tony-mikhailov/w27cxxx/docs/scheme rev.2.9.jpg

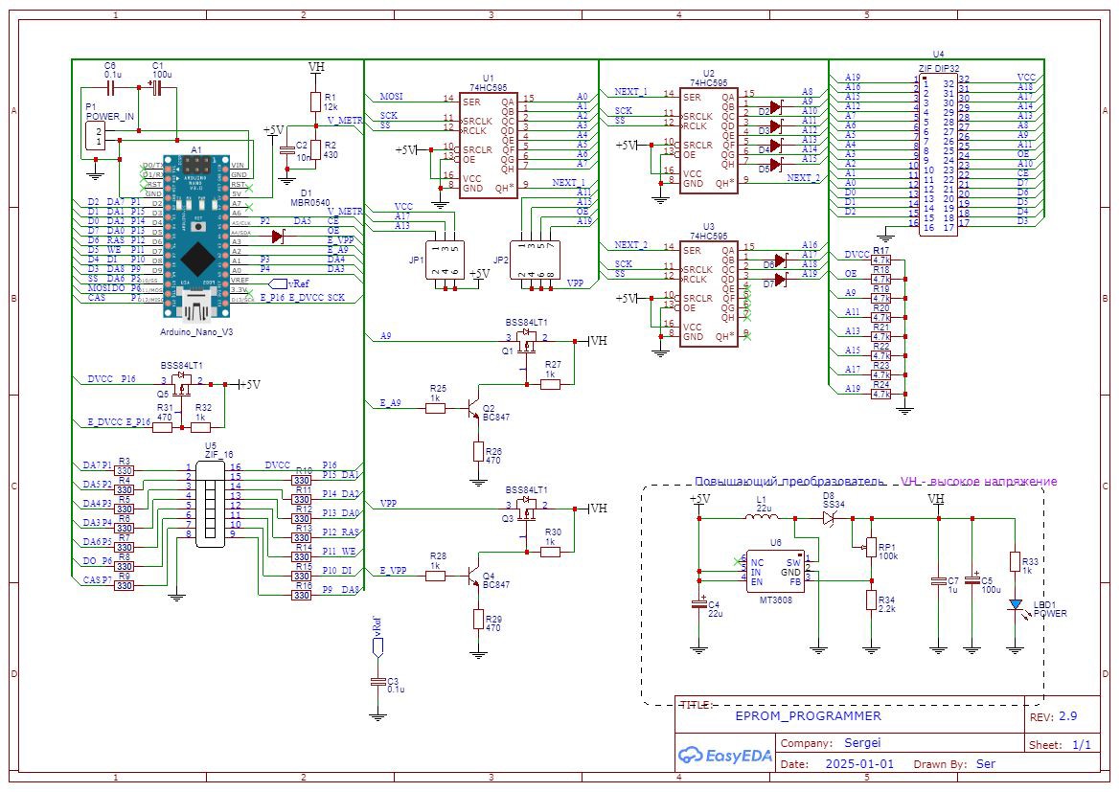
docs/scheme rev.2.9.jpg
