tony-mikhailov/w27cxxx/ListLogic.txt

Список микросхем логики

4000
4001
4002
4009
4010
40106
4011
4012
4013
4015
4016
40161
40162
4017
40174
40175
4018
4019
40192
40193
4020
4022
4023
4024
4025
4027
4028
4029
4030
4031
4040
4041
4042
4043
4044
4048
4049
4050
4051
4053
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
