tony-mikhailov/w27cxxx/docs/Screenshot from 2025-07-10 21-50-37.png

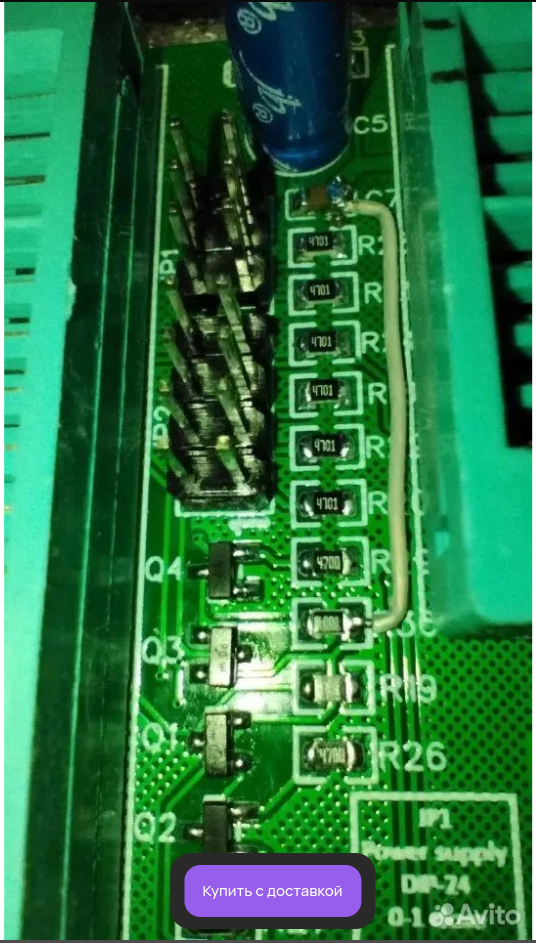
docs/Screenshot from 2025-07-10 21-50-37.png
