tony-mikhailov/w27cxxx/image.jpeg

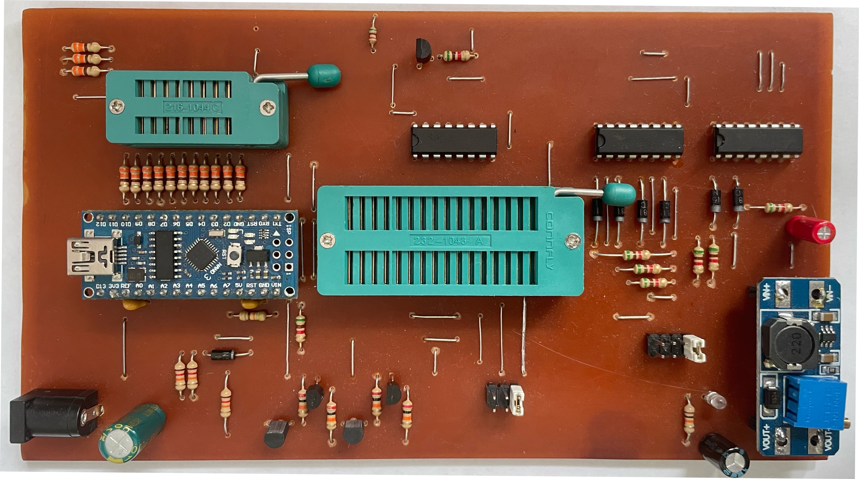
image.jpeg
