tony-mikhailov/w27cxxx/image/27c010.png

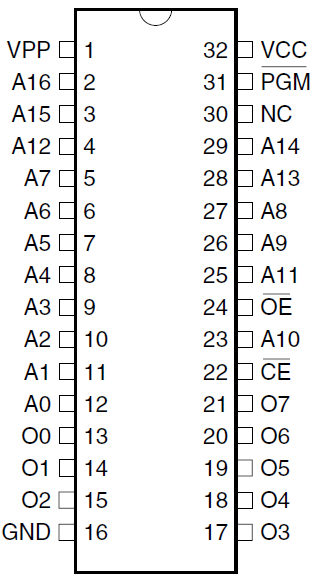
image/27c010.png
