tony-mikhailov/w27cxxx/image/27c16.png

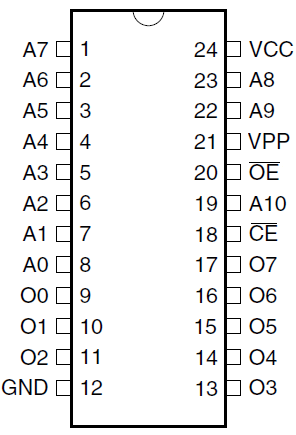
image/27c16.png
