tony-mikhailov/w27cxxx/image/27c32.png

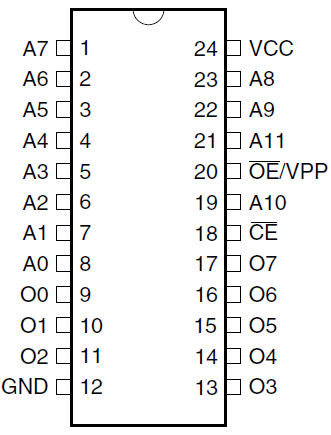
image/27c32.png
