tony-mikhailov/w27cxxx/image/28c010.png

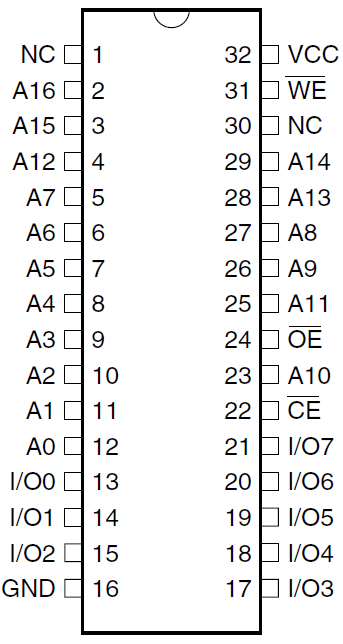
image/28c010.png
