tony-mikhailov/w27cxxx/image/28c17.png

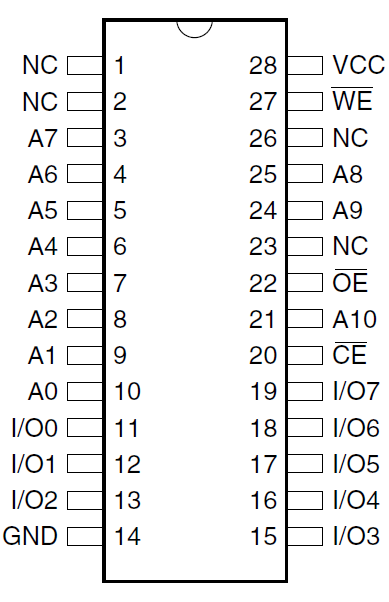
image/28c17.png
