tony-mikhailov/w27cxxx/image/dram64.png

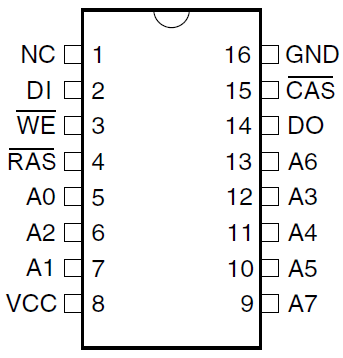
image/dram64.png
