tony-mikhailov/w27cxxx/Schematic rev1.0.png

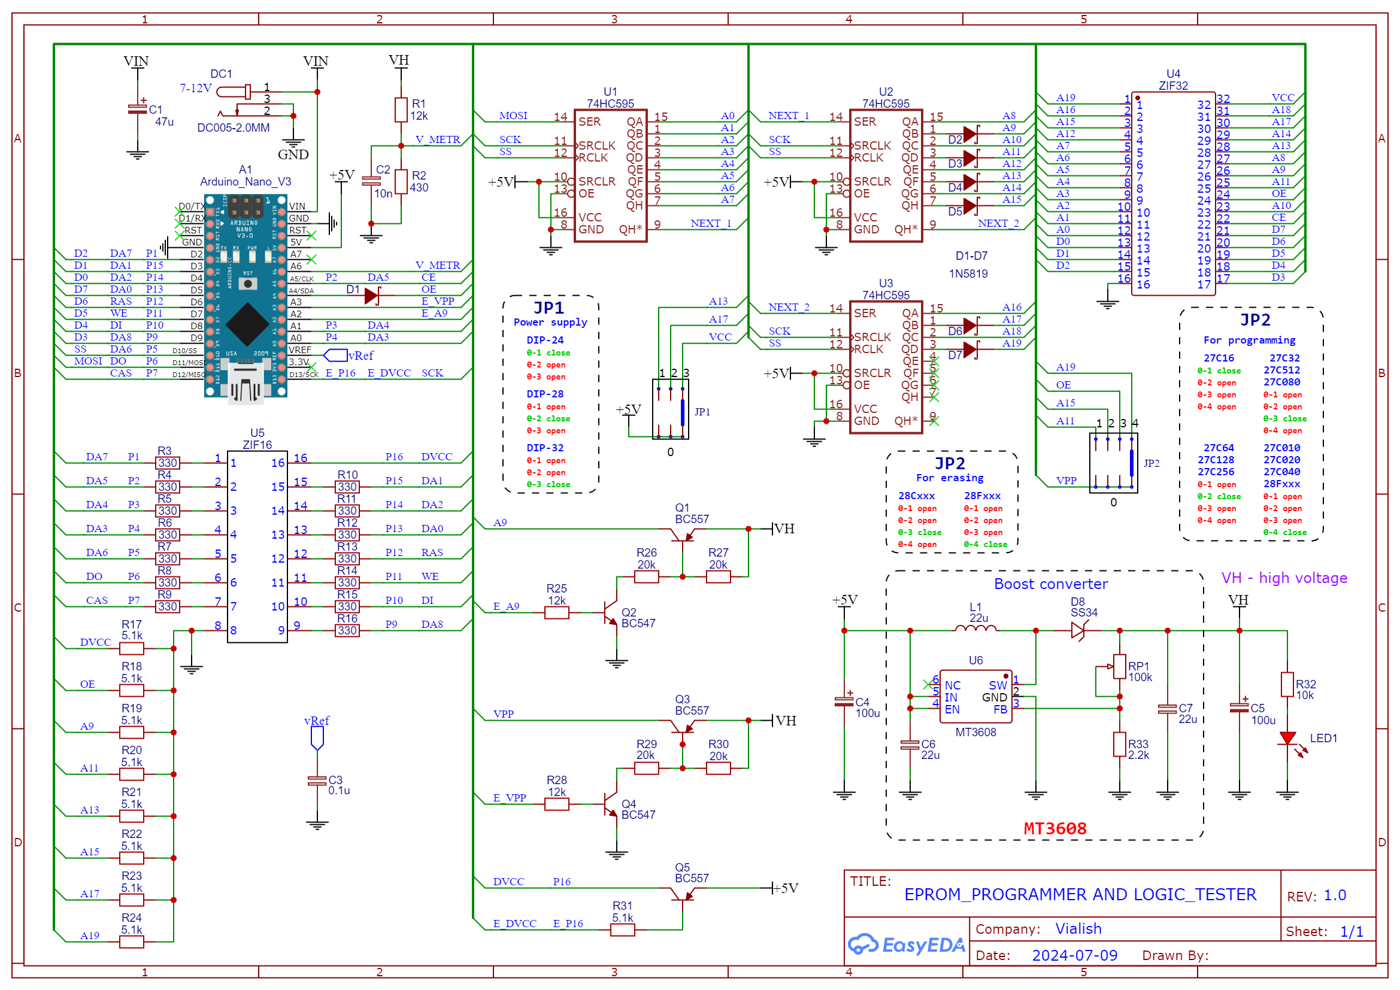
Schematic rev1.0.png
