tony-mikhailov/w27cxxx/docs/BOM.ods

 | - | C1,C5 | 100u | 1 | 25V | polar | D5.0
 | - | C2 | 10nF | 1 | SMD0805
 |  | C3,C6 | 0.1u | 2 | SMD0805
 | - | C4 | 22u | 1 | 25V | polar | D5.0
 | - | C7 | 1u | 1 | SMD0805
+ |  | R1 | 12k | 1 | SMD0805
+ |  | R2 | 430 | 1 | SMD0805
 | NU | R3-R16 | 330 | 14 | SMD0805 | NU
+ |  | R17-R24 | 4.7k | 8 | SMD0805
+ |  | R25,R27,R28,R30,R33 | 1k | 5 | SMD0805
+ |  | R26, R29 | 470 | 2 | SMD0805
 | NU | R31 | 9 |  | SMD0805 | NU
 | NU | R32 | 1k |  | SMD0805 | NU
+ |  | R34 | 2.2k | 1 | SMD0805
+ |  | RP1 | 100k | 1
 | + | D1-D7 | MBR0540 | 7
 |  | D8 | SS34 | 1 | smd?
 |  | LED1
 | + | Q1,Q3 | BSS84LT1 | 2
 | + | Q2,Q4 | BC847 | 2
 | NU | Q5 | BSS84LT1 | 1 |  | NU
 |  | L1 | 22u | 1
 | + | U1,U2,U3 | 74HC595
 |  | U6 | MT3608
 | + | A1 | Arduino Nano v.3
 | + | XP1 | ZIF32
