tony-mikhailov/w27cxxx/(commit log)

2025-12-26 add origin arch and docs folders
    [BOM.ods]
2026-01-16 + фикс чтения M27C64
